Zulu-Platform/Zulu-DataPlane/docs/Power.pdf

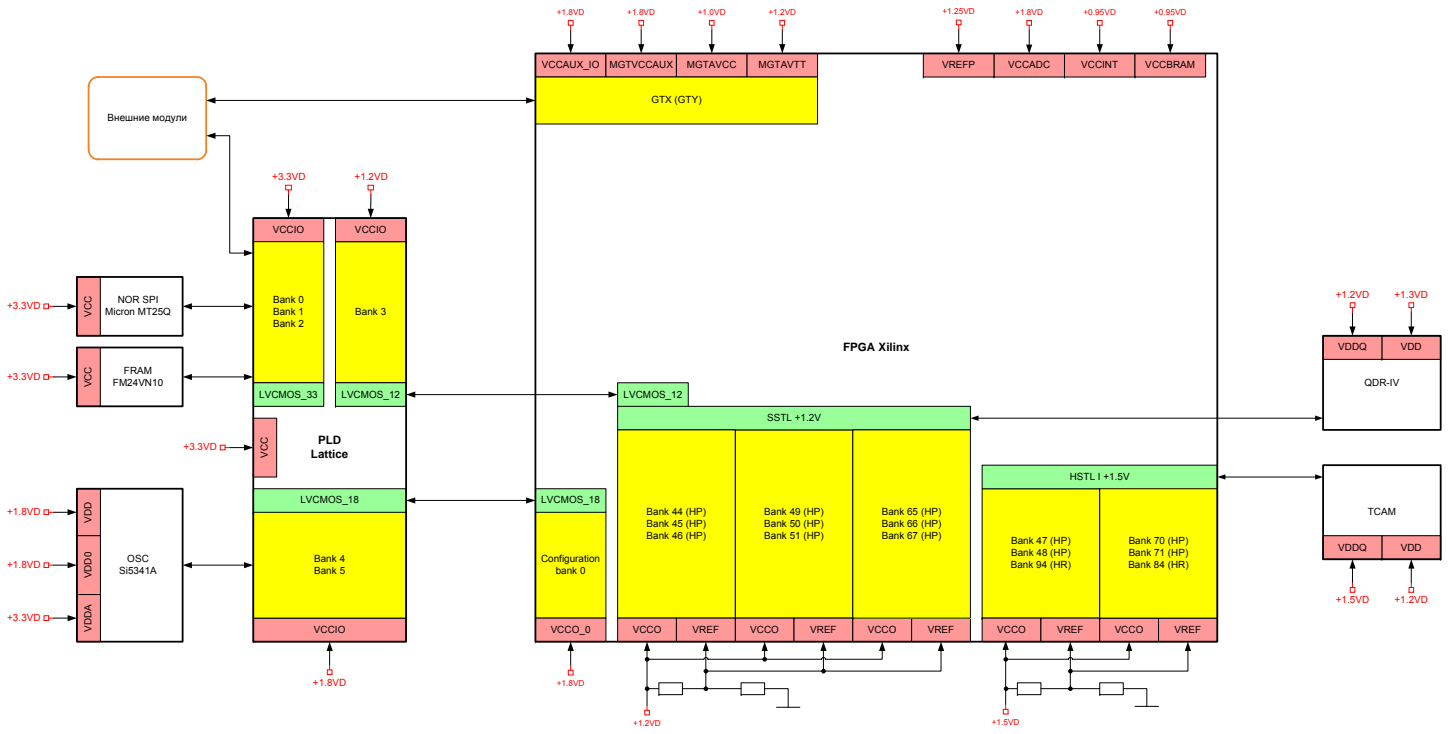
[picture p1: figure]
VCCAUX_IO; MGTVCCAUX; MGTAVCC; MGTAVTT; Bank 47 (HP) Bank 48 (HP) Bank 94 (HR); VCC+3.3VD; VCCINT; VCCBRAM; VCCO; VREF; HSTL I +1.5V; VDDQ; VDD; Внешние модули; GTX (GTY); VREFP; VCCADC; PLD Lattice; VCCIO; Bank 0 Bank 1 Bank 2; Bank 3; Bank 4 Bank 5; LVCMOS_33; LVCMOS_18; LVCMOS_12; VDD+1.8VD; VDD0 +1.8VD; VDDA +3.3VD; Configuration bank 0; VCCO_0; Bank 70 (HP) Bank 71 (HP) Bank 84 (HR); Bank 49 (HP) Bank 50 (HP) Bank 51 (HP); SSTL +1.2V; Bank 65 (HP) Bank 66 (HP) Bank 67 (HP); Bank 44 (HP) Bank 45 (HP) Bank 46 (HP); FPGA Xilinx; NOR SPI Micron MT25Q; FRAM FM24VN10; OSC Si5341A; QDR-IV; TCAM
