Zulu-Platform/Zulu-DataPlane/docs/Configuration.pdf

# DATA PLANE

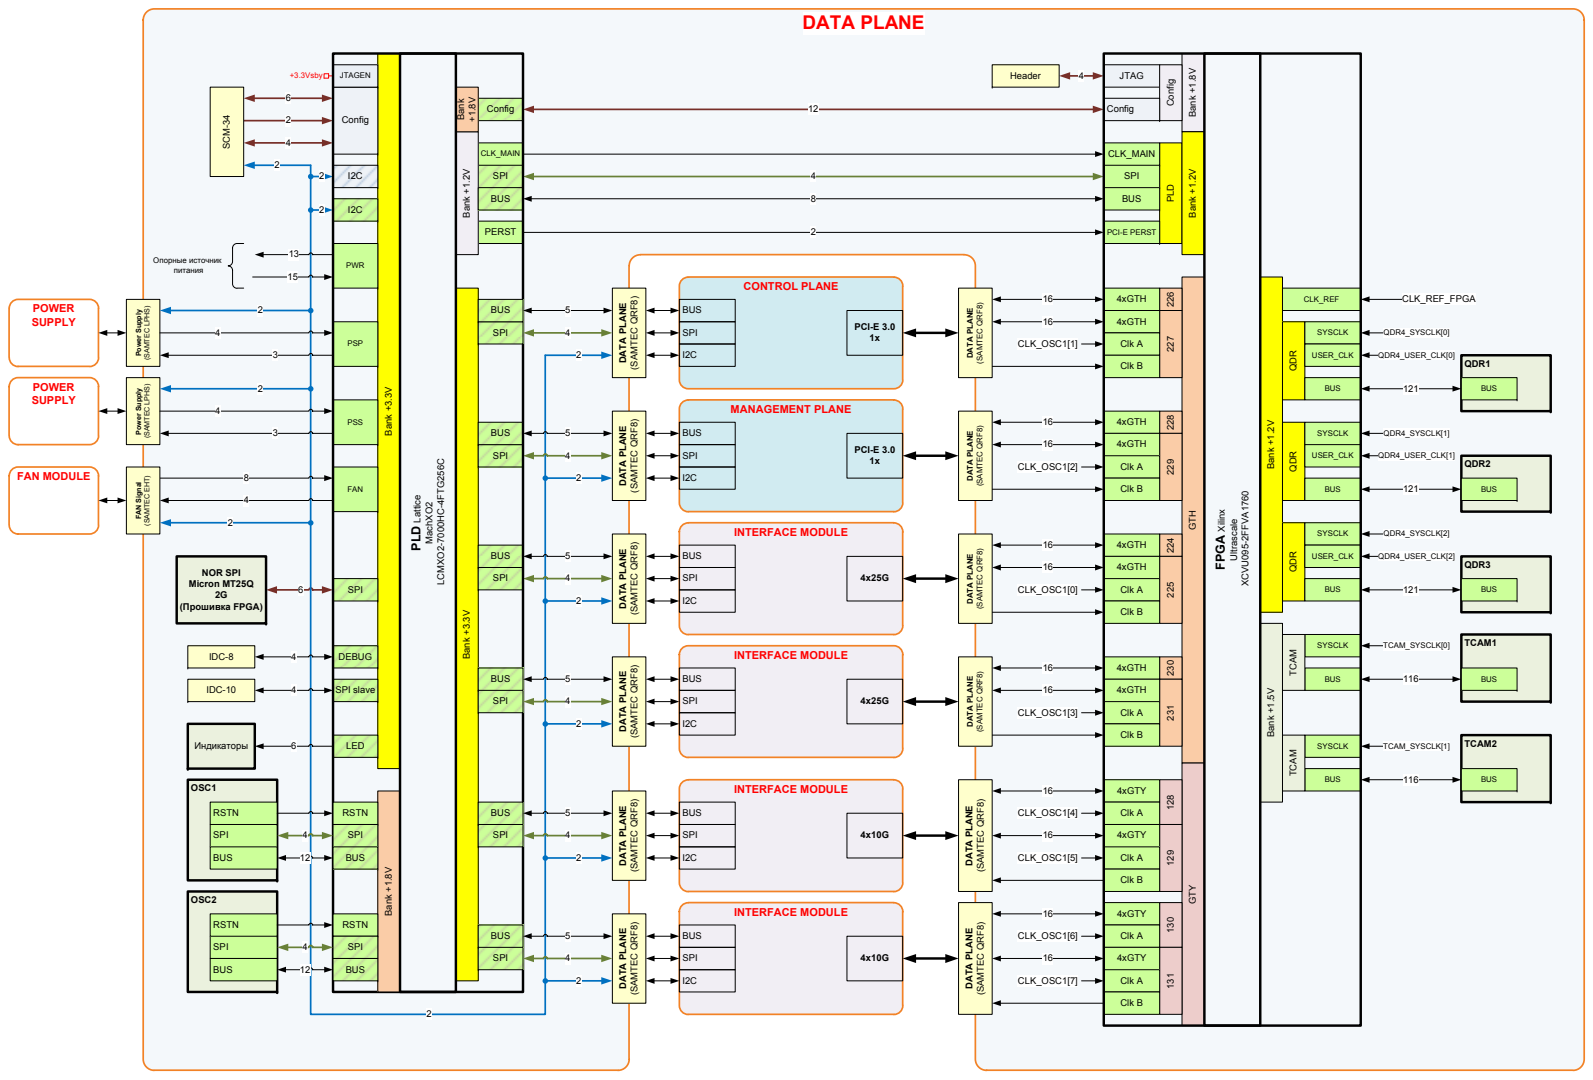
[picture p2: page 1]
INTERFACE MODULE; MANAGEMENT PLANE; CONTROL PLANE; NOR SPI Micron MT25Q 2G (Прошивка FPGA); Bank +3.3V; SPI; Config; +3.3Vsby; JTAGEN; SCM-34; I2C DATA PLANE; (SAMTEC QRF8) SPI 4; CLK_MAIN; PERST; Bank +1.2V BUS 8; BUS; Power Supply; PSP; Опорные источник питания; FAN Signal; (SAMTEC EHT); FAN MODULE; PSS; LED; DEBUG; IDC-10; SPI slave; IDC-8; Индикаторы; PWR; FAN; OSC1; RSTN; Header; TCAM2; Bank +1.2V; JTAG; Bank +1.8V; Config PLD; SYSCLK BUS TCAM; GTH; Bank +1.5V; TCAM_SYSCLK[1]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

(SAMTEC LPHS) POWER SUPPLY

QDR QDR QDR
USER_CLK
