Zulu-Platform/Zulu-DataPlane/docs/Lattice.pdf

## DATA PLANE

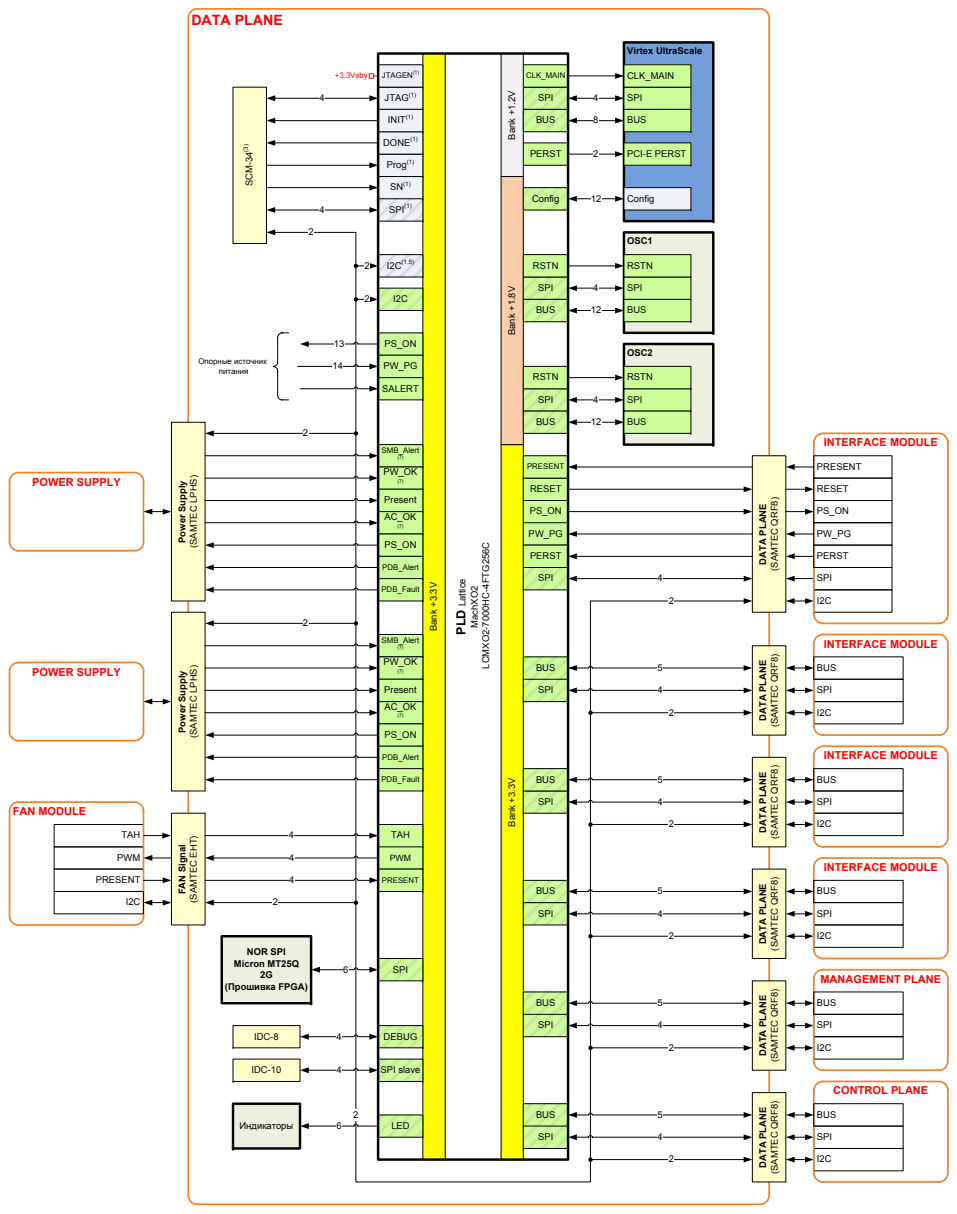
[picture p3: page 1]
NOR SPI Micron MT25Q 2G (Прошивка FPGA); Virtex UltraScale; SPI; Config; Bank +3.3V; Bank +1.8V; JTAG⁽¹⁾; Prog⁽¹⁾; DONE⁽¹⁾; JTAGEN⁽¹⁾ +3.3Vsby; SCM-34(3); INIT⁽¹⁾; DATA PLANE; (SAMTEC QRF8); I2C DATA PLANE; (SAMTEC QRF8) SPI 4; INTERFACE MODULE; CLK_MAIN; SPI⁽¹⁾; PERST; PCI-E PERST; RESET; PRESENT; BUS; MANAGEMENT PLANE; CONTROL PLANE; Power Supply; SMB_Alert (7) PW_OK; Present; PDB_Alert; PDB_Fault; Опорные источник питания; SALERT; FAN Signal; PWM; TAH; FAN MODULE; LED; DEBUG; IDC-10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

Bank +1.2V BUS 8 BUS
SPI

(SAMTEC LPHS) POWER SUPPLY

(SAMTEC EHT)TAH
