Zulu-Platform/Zulu-DataPlane/docs/Power sequence.pdf

PSP Power sequence | PSS Power sequence

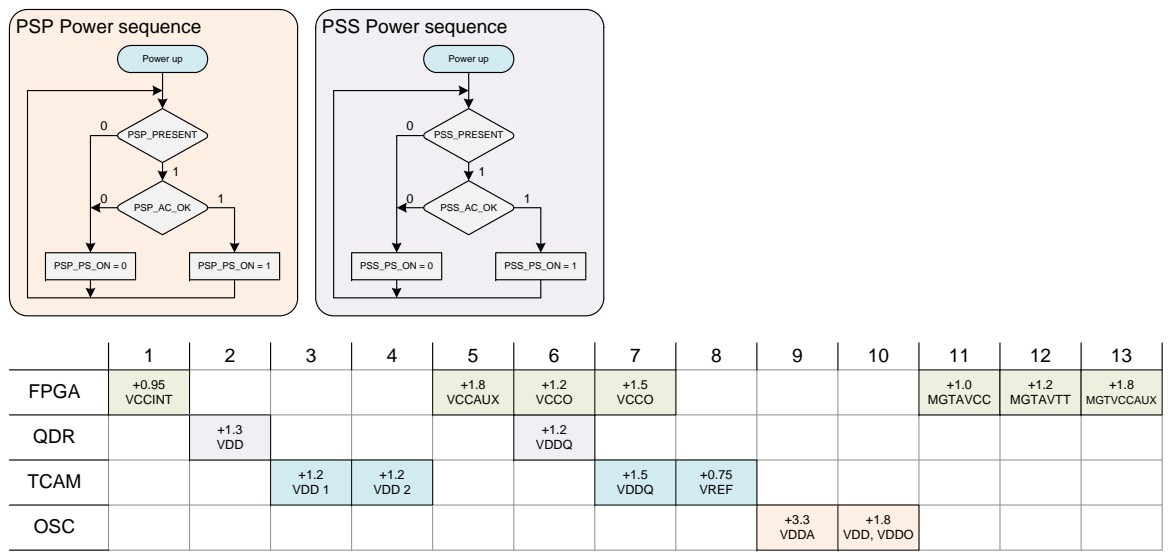
[picture p4: page 1]
Power up; PSP_PRESENT; PSP_AC_OK; PSP_PS_ON = 0; PSP_PS_ON = 1; PSS_PRESENT; PSS_AC_OK; PSS_PS_ON = 0; PSS_PS_ON = 1; FPGA; QDR; OSC; TCAM; +0.95 VCCINT; +3.3 VDDA; +1.2 VDD 1; +1.3 VDD; +1.2 VDD 2; +1.8 VCCAUX; +1.8 VDD, VDDO; +1.2 VDDQ; +1.2 VCCO; +1.5 VCCO; +1.5 VDDQ; +0.75 VREF; +1.0 MGTAVCC; +1.2 MGTAVTT; +1.8 MGTVCCAUX
