Zulu-Platform/Zulu-DataPlane/docs/Xilinx.pdf

## DATA PLANE

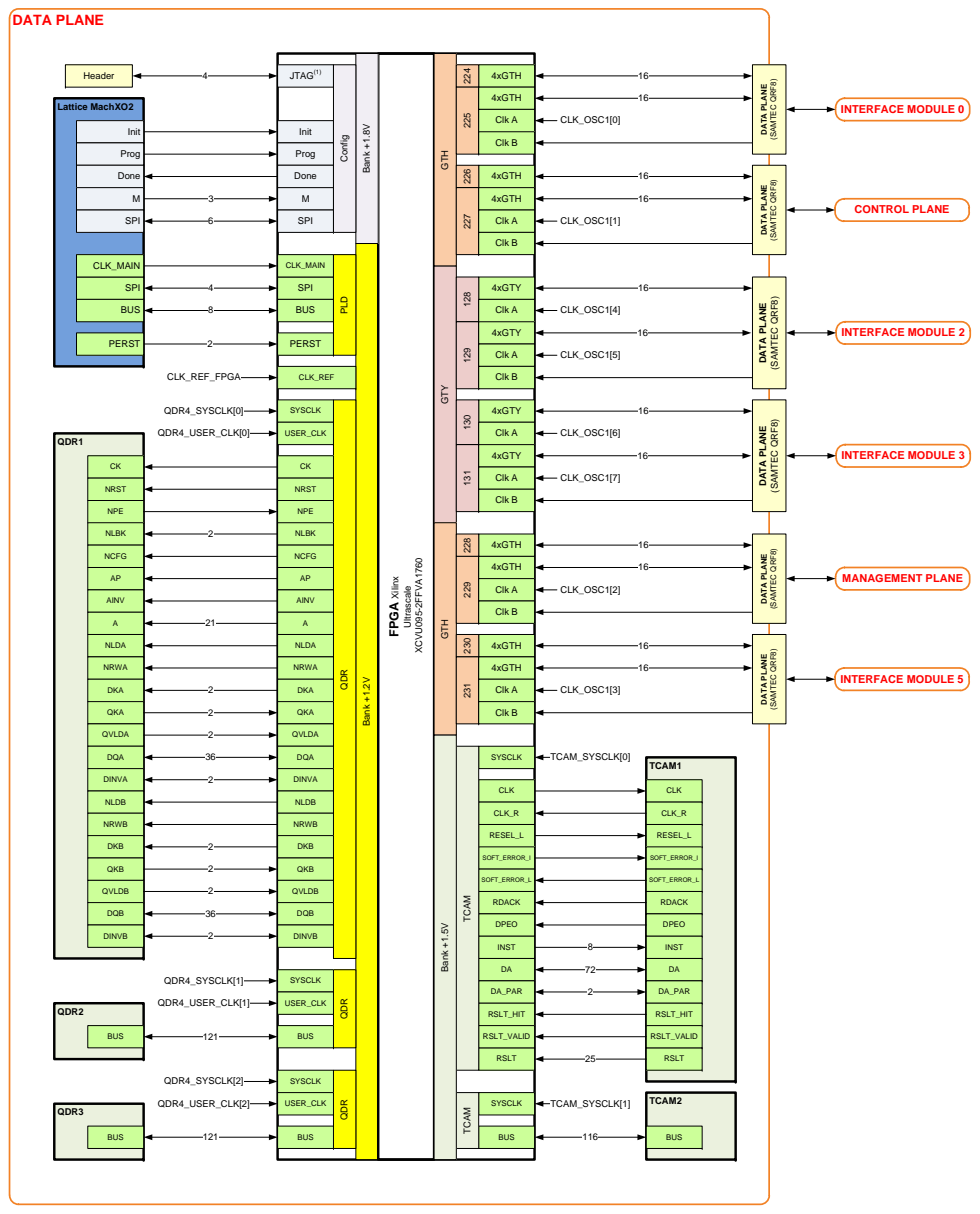
[picture p5: page 1]
CONTROL PLANE; Header; Lattice MachXO2; MANAGEMENT PLANE; INTERFACE MODULE 2; DATA PLANE; (SAMTEC QRF8); INTERFACE MODULE 3; INTERFACE MODULE 0; INTERFACE MODULE 5; TCAM1; CLK; CLK_R; RESEL_L; SOFT_ERROR_I; SOFT_ERROR_L; RDACK; DPEO; INST; DA_PAR; RSLT; RSLT_HIT; RSLT_VALID; TCAM2; BUS; QDR1; NRST; NPE; NLBK; NCFG; AINV; NLDA; NRWA; DKA; QKA; QVLDA; DQA; DINVA; NLDB; NRWB; DKB; QKB; QVLDB; DQB; DINVB; QDR2; QDR3; SPI; Init; CLK_MAIN; PERST; Prog; Done; Bank +1.2V; JTAG⁽¹⁾; CLK_REF; SYSCLK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
