Zulu-Platform/Zulu-DataPlane/docs/zulu-platform.pdf

## Power

## Power

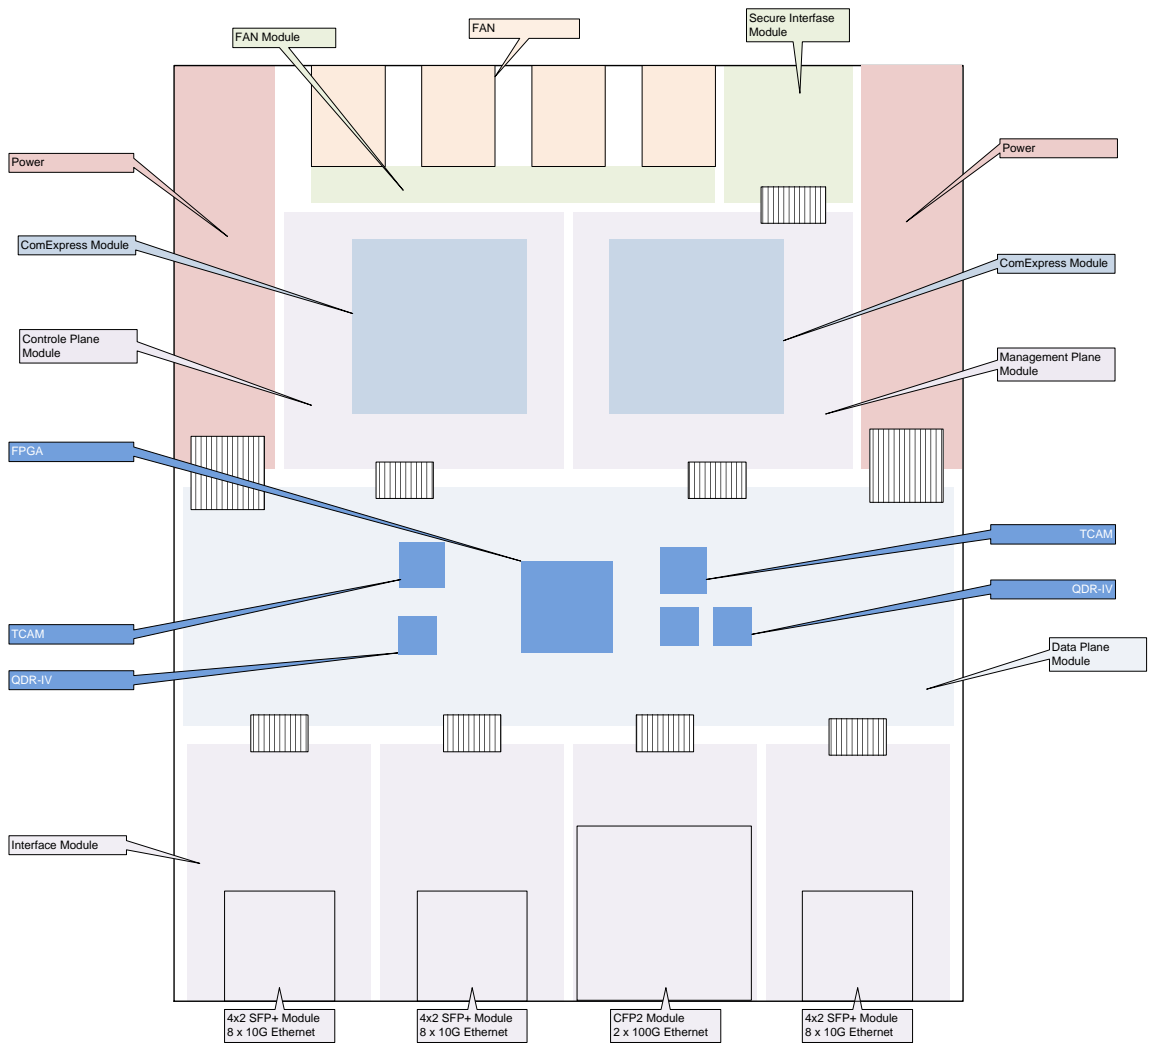
[picture p6: page 1]
Interface Module; Data Plane Module; CFP2 Module 2 x 100G Ethernet; 4x2 SFP+ Module 8 x 10G Ethernet; QDR-IV; Secure Interfase Module; FPGA; TCAM; ComExpress Module; Management Plane Module; Controle Plane Module; FAN; FAN Module

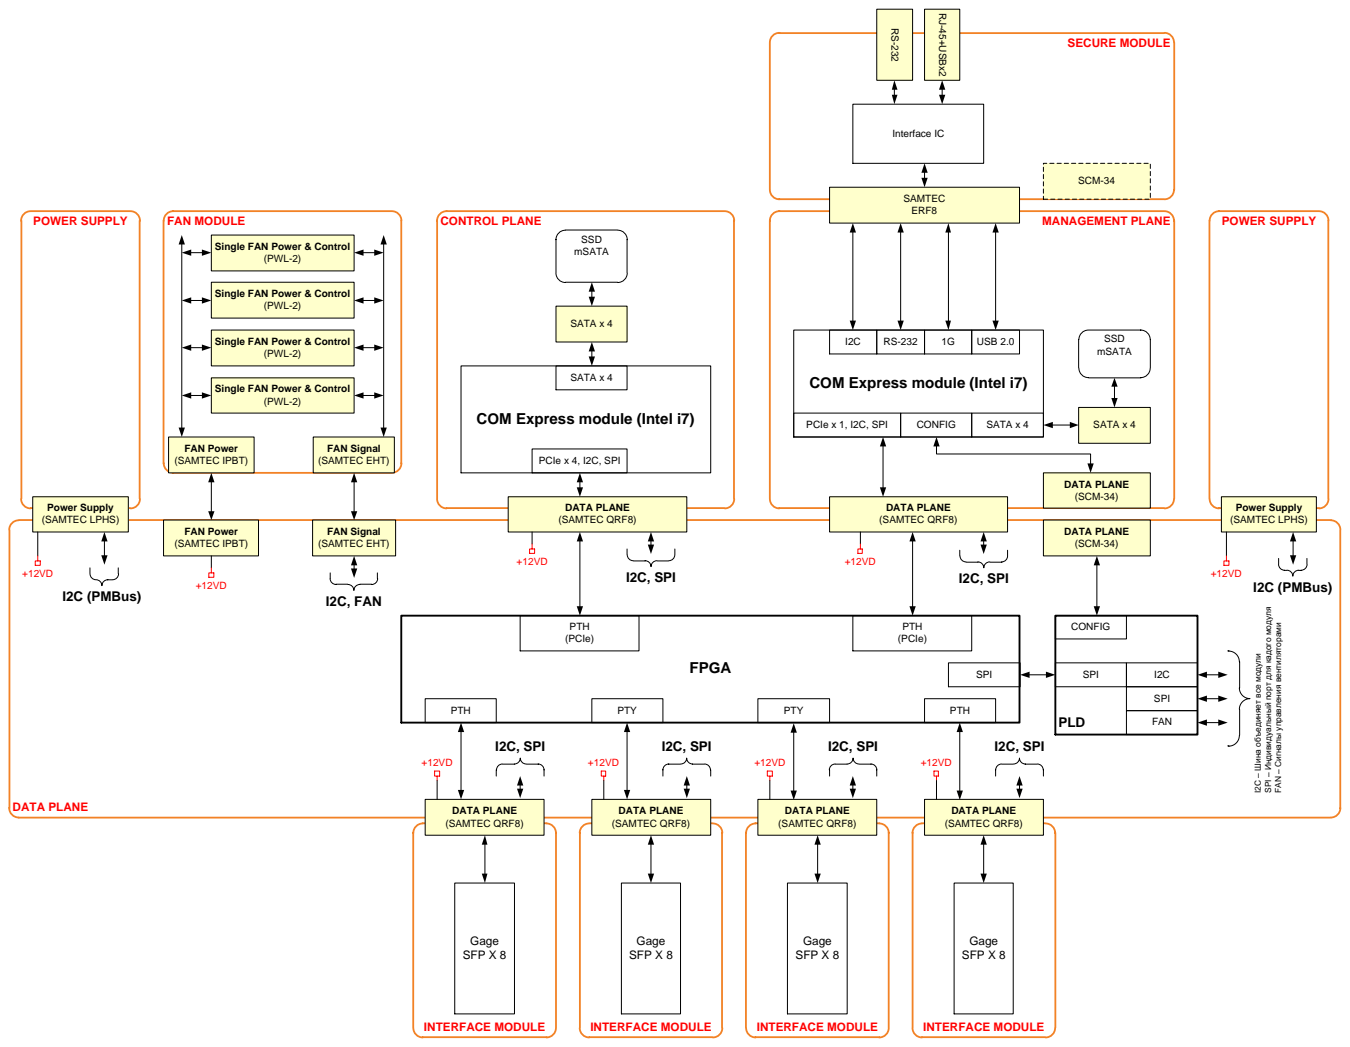
[picture p7: page 2]
FPGA; PCIe x 1, I2C, SPI; MANAGEMENT PLANE; SATA x 4; PTH; Gage SFP X 8; PTH (PCIe); INTERFACE MODULE; DATA PLANE; DATA PLANE (SAMTEC QRF8); USB 2.0; SECURE MODULE; Interface IC; POWER SUPPLY; SSD mSATA; Power Supply (SAMTEC LPHS); SAMTEC ERF8; FAN MODULE; FAN Power (SAMTEC IPBT); (PWL-2); PCIe x 4, I2C, SPI; CONTROL PLANE; I2C, SPI; PTY; I2C (PMBus); I2C, FAN; PLD; SPI; FAN; Шина; диня; Индивид; льный порт д; ого; Сигна; управл; ения вентил; ятора; FAN Signal (SAMTEC EHT); DATA PLANE (SCM-34)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

Single FAN Power & Control

COM Express module (Intel i7)
