Zulu-Platform/Zulu-DataPlane/(list of files, drawings)

Other design files:
hw/gen0/schematic/Data_Plane.DSN
