Zulu-Platform/Zulu-DataPlane/hw/gen0/manufacturing/Data_Plane_16L-stack-up.xls

Layer No. | Layer Type | Cu thk. w/o plating | Layer Thick. (mm) | Impedance Target / Calculation | Trace width (mm) | ref. Plane layer | Diff. Impedance Target / Calculation | Trace width/space (mm) | ref. Plane layer
 | s/m |  | 0.02
1 | SIG | 0.03 |  | 50 / 50.8 | 0.13 | L2 | 100 / 95.89 | 0.11 / 0.16 | L2 | Top | 0.012 + plating
PP, Megtron-4, Er=3.7 |  |  | 0.076 |  |  |  |  |  |  |  | Low Dk material
2 | Plane | 0.012 |  |  |  |  |  |  |  | PWR1
Core,Megtron-4, Er=3.7 |  |  | 0.125 |  |  |  |  |  |  |  | Low Dk material
3 | SIG | 0.012 |  | 50 / 50.24 | 0.115 | L2&L4 | 100 / 95.18 | 0.11 / 0.22 | L2&L4 | INT1
PP, Megtron-4, Er=3.7 |  |  | 0.125 |  |  |  |  |  |  |  | Low Dk material
4 | Plane | 0.012 |  |  |  |  |  |  |  | PWR2
Core,Megtron-4I, Er=3.7 |  |  | 0.125 |  |  |  |  |  |  |  | Low Dk material
5 | SIG | 0.018 |  | 50 / 50.24 | 0.115 | L4&L6 | 100 / 95.18 | 0.11 / 0.22 | L4&L6 | INT3
PP, Megtron-4, Er=3.7 |  |  | 0.125 |  |  |  |  |  |  |  | Low Dk material
6 | Plane | 0.018 |  |  |  |  |  |  |  | PWR3
Core High Tg, Er=3.95 |  |  | 0.125
7 | MIXED | 0.018 |  | 50 / 49.44 | 0.1 | L6&L8 | 100 / 92.12 | 0.11 / 0.22 | L6&L8 | INT5
PP High Tg, Er=3.95 |  |  | 0.125
8 | Plane | 0.035 |  |  |  |  |  |  |  | PWR4
Core,FR-4 High Tg |  |  | 0.076
9 | Plane | 0.035 |  |  |  |  |  |  |  | PWR5
PP High Tg, Er=3.95 |  |  | 0.125
10 | MIXED | 0.018 |  | 50 / 49.44 | 0.1 | L9&L11 | 100 / 92.12 | 0.11 / 0.22 | L9&L11 | INT6
Core High Tg, Er=3.95 |  |  | 0.125
11 | Plane | 0.018 |  |  |  |  |  |  |  | PWR6
PP, Megtron-4, Er=3.7 |  |  | 0.125 |  |  |  |  |  |  |  | Low Dk material
12 | SIG | 0.012 |  | 50 / 50.24 | 0.115 | L11&L13 | 100 / 95.18 | 0.11 / 0.22 | L11&L13 | INT4
Core,Megtron-4, Er=3.7 |  |  | 0.125 |  |  |  |  |  |  |  | Low Dk material
13 | Plane | 0.012 |  |  |  |  |  |  |  | PWR7
PP, Megtron-4, Er=3.7 |  |  | 0.125 |  |  |  |  |  |  |  | Low Dk material
14 | SIG | 0.012 |  | 50 / 50.24 | 0.115 | L13&L15 | 100 / 95.18 | 0.11 / 0.22 | L13&L15 | INT2
Core,Megtron-4, Er=3.7 |  |  | 0.125 |  |  |  |  |  |  |  | Low Dk material
15 | Plane | 0.012 |  |  |  |  |  |  |  | PWR8
PP, Megtron-4, Er=3.7 |  |  | 0.076 |  |  |  |  |  |  |  | Low Dk material
16 | SIG | 0.03 |  | 50 / 50.8 | 0.13 | L13 | 100 / 95.89 | 0.11 / 0.16 | L15 | Bot | 0.012 + plating
 | s/m |  | 0.02
 |  | Total THK: | 2.072
External layers
Internal Layer (SIG)
Internal Layer (MIXED)
