Zulu-Platform/Zulu-DataPlane/(commit log)

2015-08-11 hw release: pcb layout, gerber, schematic, stack-up
    [Data_Plane.DSN, Data_Plane_16L-stack-up.xls]
2015-08-11 add ODB++ format pcb add pdf format schematic
2015-09-22 Add architecture docs: - configuration functional scheme - power and power sequence functional scheme - Lattice and Xilinx functional scheme
